Sphyrna-029/Pico-Pilot/README.md

# Pico-Pilot WIP
A auto pilot for land/air/sea based robots built on the RP2350B/RP2354B. Supports 2D waypoint missions, telemetry, and custom vehicle configuration. 
Requires simple_pid and warnings packages. 

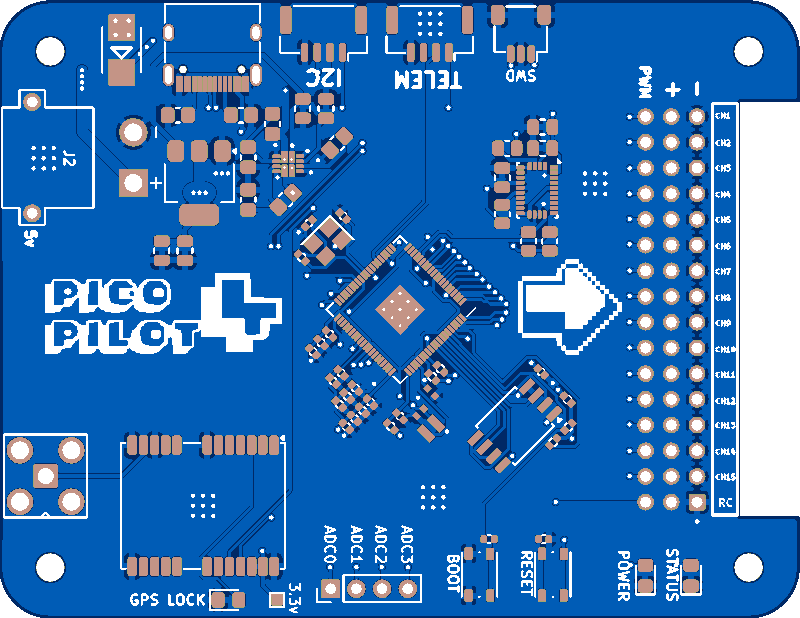
[picture p1: images/Pico4.png]
PicoPilot v4
