Sphyrna-029/Pico-Pilot/images/Pico3.PNG

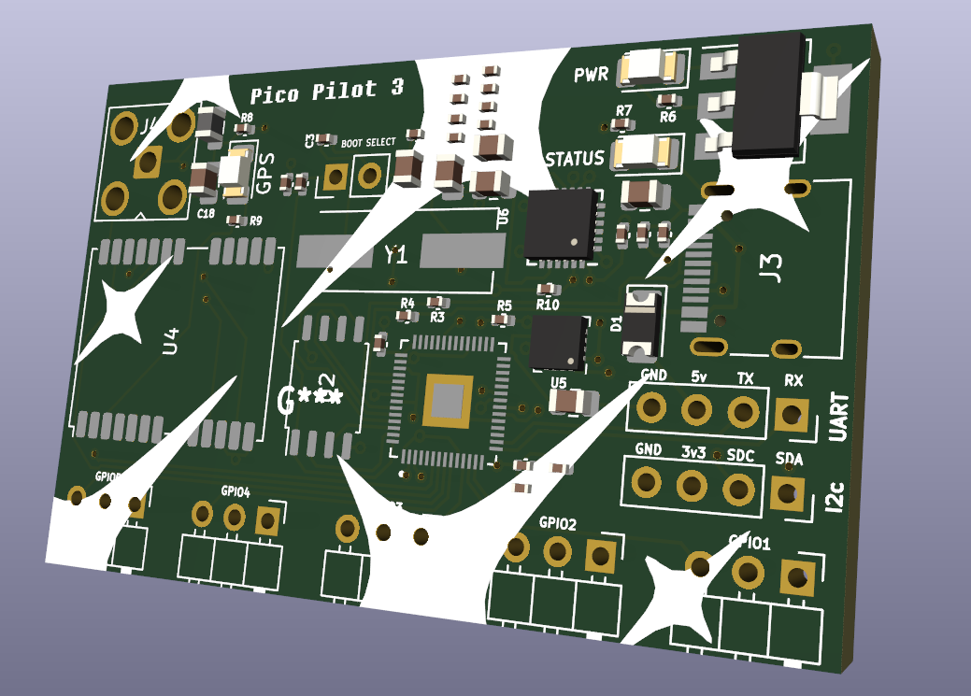
images/Pico3.PNG
