Sphyrna-029/Pico-Pilot/images/pico_2.jpg

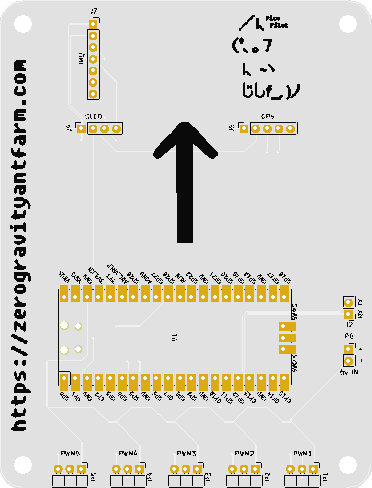
images/pico_2.jpg
