Sphyrna-029/Pico-Pilot/images/PicoPilot.png

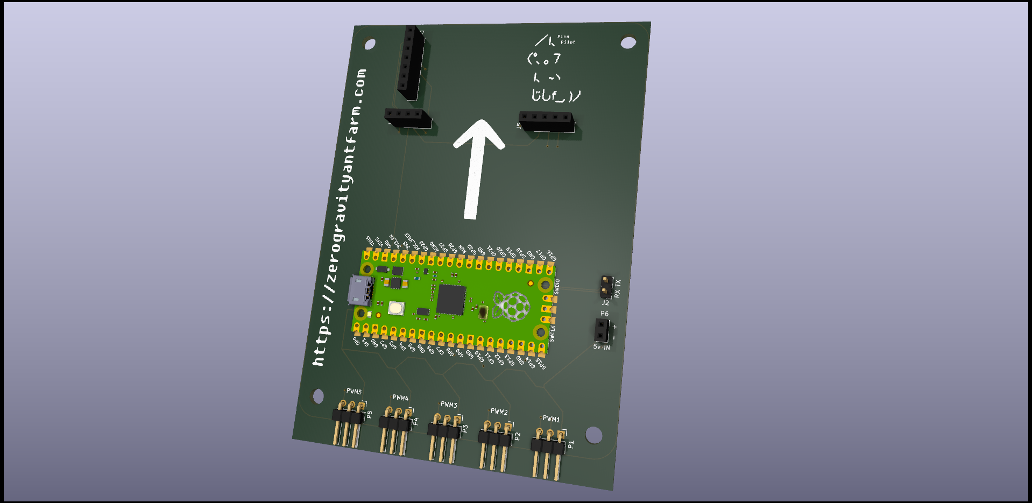
images/PicoPilot.png
