Sphyrna-029/Pico-Pilot/images/PicoPilotv02.PNG

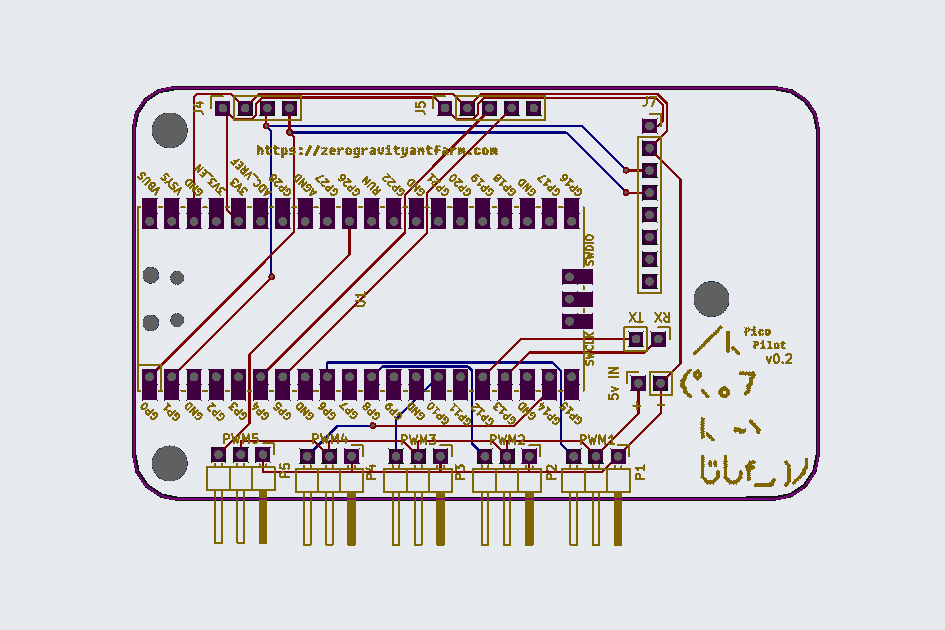
images/PicoPilotv02.PNG
