Sphyrna-029/Pico-Pilot/images/PicoPilotv03.PNG

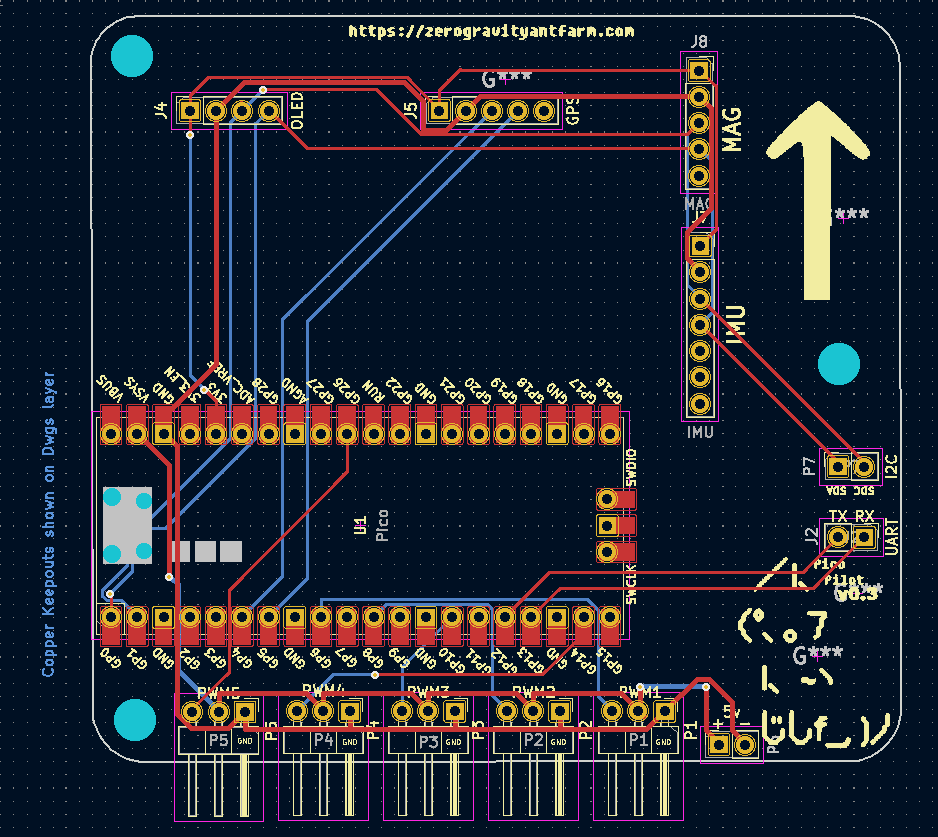
images/PicoPilotv03.PNG
