Sphyrna-029/Pico-Pilot/pcb/RP2350_QFN80.step

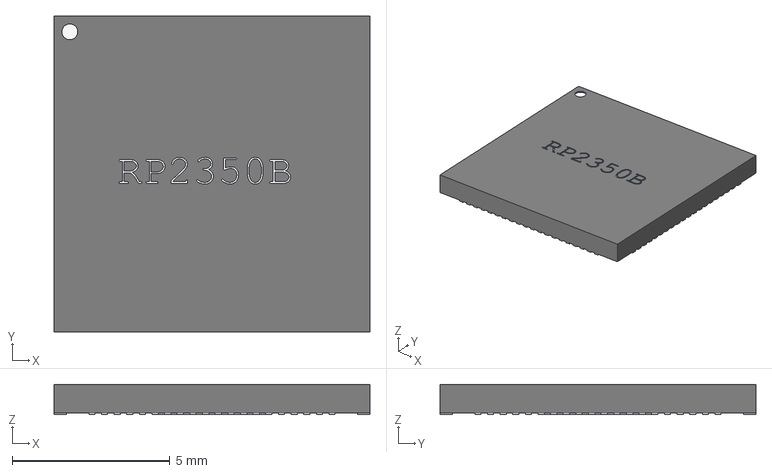
[picture p7: CAD file, 2024-08-15]
pcb/RP2350_QFN80.step
10.0 x 10.0 x 0.95 mm
