Sphyrna-029/Pico-Pilot/pcb/RP2350_80QFN_minimal.kicad_pcb

## KiCad design pcb/RP2350_80QFN_minimal.kicad_pcb (2024-08-17)

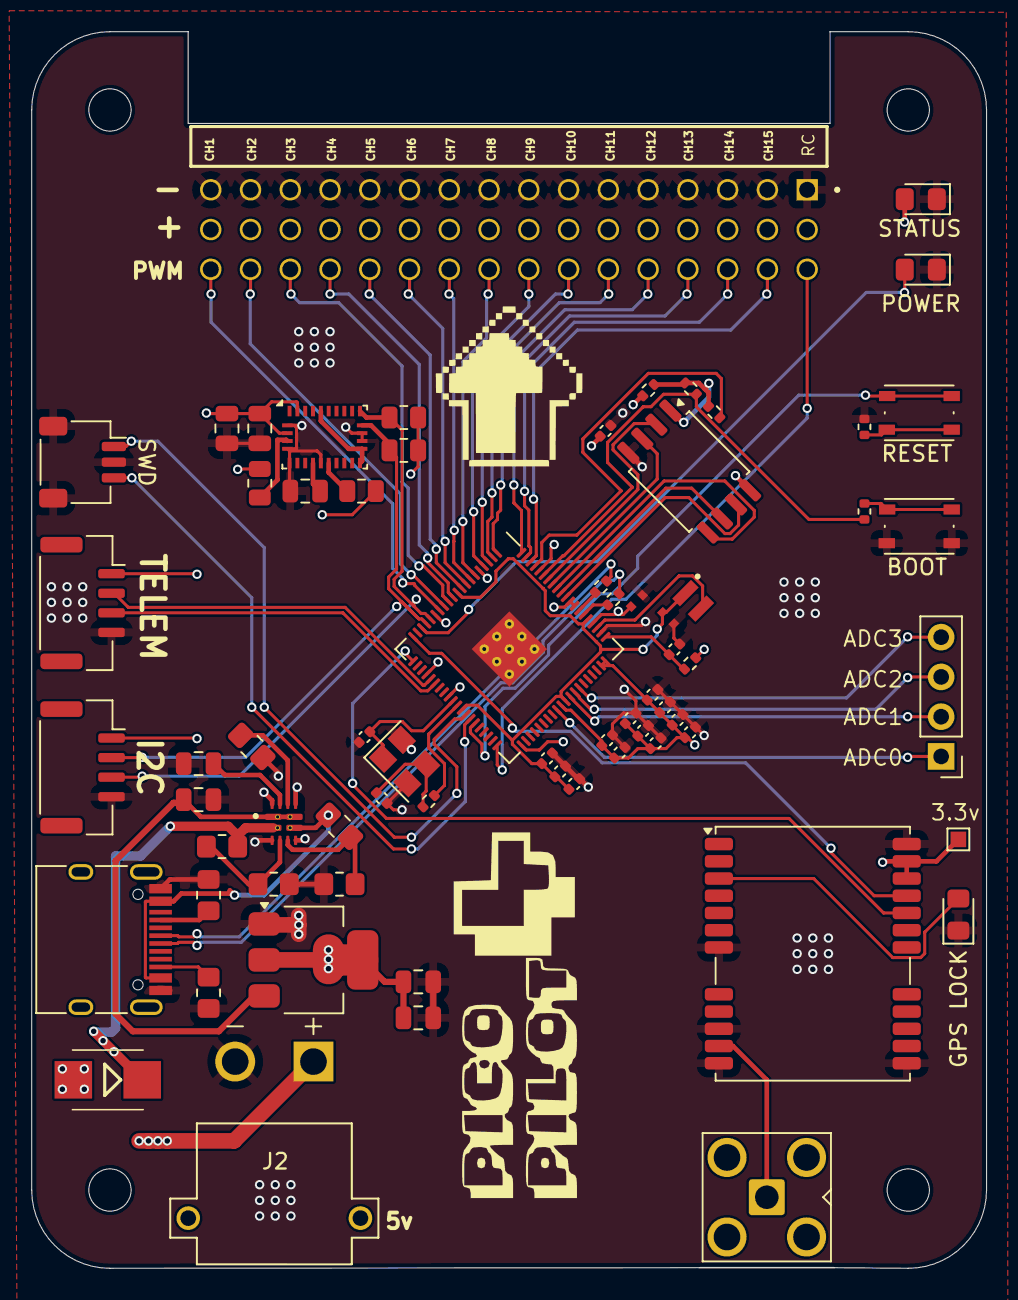
[picture p8: board RP2350_80QFN_minimal.kicad_pcb from above]

Board: 4 copper layers, 61.0 x 79.0 mm, 72 parts (0 on the bottom side), 68 nets.

Parts:
BOOT: SW_Push; SW_Push_1P1T_NO_Vertical_Wuerth_434133025816
C1, C5, C19: 10u; C_0805_2012Metric
C2, C8, C11, C12, C13, C14, C15, C16, C17, C18, C20, C21: 100n; C_0402_1005Metric
C3, C4: 15p; C_0402_1005Metric
C6, C7: 4.7u; C_0402_1005Metric_small_pads
C9, C10: 4.7u; C_0402_1005Metric
C22: 100nF; C_0805_2012Metric
C23: 120nF; C_0805_2012Metric
C24: 6.8nF; C_0805_2012Metric
C25: 0.01u; C_0805_2012Metric
D1, D2, D3: LED; LED_0805_2012Metric_Pad1.15x1.40mm_HandSolder
D4: SS56; SMB
H1, H2, H3, H4: MountingHole; MountingHole_2.7mm_M2.5
J1: USB_C_Receptacle_USB2.0_14P; USB_C_Receptacle_HRO_TYPE-C-31-M-12
J2: XT30PW-M; AMASS_XT30PW-M
J3, J6: Conn_01x04_Pin; Molex_CLIK-Mate_502386-0470_1x04-1MP_P1.25mm_Horizontal
J4: SM03B-SRSS-TB; JST_SH_SM03B-SRSS-TB_1x03-1MP_P1.00mm_Horizontal
J5: TSW-116-08-G-T-RA; SAMTEC_TSW-116-08-G-T-RA
J7: Conn_01x04_Pin; PinHeader_1x04_P2.54mm_Vertical
J8: Conn_Coaxial_Small; SMA_Amphenol_901-143_Horizontal
L1: 3.3u; L_pol_2016
R1, R9: DNF; R_0402_1005Metric
R2, R4, R6: 1k; R_0402_1005Metric
R3: 33; R_0402_1005Metric
R5, R12: 5.1k; R_0805_2012Metric_Pad1.20x1.40mm_HandSolder
R7, R8: 27; R_0402_1005Metric
R10: 0; R_0402_1005Metric
R11, R15: 10k; R_0805_2012Metric
R13, R14: 4.7k; R_0805_2012Metric
R16: 51.1k; R_0805_2012Metric_Pad1.20x1.40mm_HandSolder
R17, R19: 23.7k; R_0805_2012Metric_Pad1.20x1.40mm_HandSolder
R18, R20: 5k; R_0805_2012Metric_Pad1.20x1.40mm_HandSolder
RESET: SW_Push; SW_Push_1P1T_NO_Vertical_Wuerth_434133025816
TP1: TestPoint; TestPoint_Pad_1.0x1.0mm
U1: RP2350_80QFN; RP2350-QFN-80-1EP_10x10_P0.4mm_EP3.4x3.4mm_ThermalVias
U2: NCP1117-3.3_SOT223; SOT-223-3_TabPin2
U3: W25Q128JVS; SOIC-8_5.23x5.23mm_P1.27mm
U4: NEO-M9N; ublox_NEO
U5: BNO055; LGA-28_5.2x3.8mm_P0.5mm
U6: TPS2121RUXR; IC_TPS2121RUXR
Y1: ABM8-272-T3; Crystal_SMD_3225-4Pin_3.2x2.5mm

Connections:
+1V1: C7.1, C8.1, C10.1, C11.1, L1.1, U1.10 (DVDD), U1.32 (DVDD), U1.51 (DVDD), U1.65 (VREG_FB)
+3V3: C2.1, C5.1, C6.1, C12.1, C13.1, C14.1, C15.1, C16.1, C17.1, C18.1, C19.1, C20.1, C21.1, C23.2, C24.2, D2.2 (A), J3.1, J6.1, R1.1, R3.1, R11.1, R13.2, R14.2, R15.1, TP1.1, U1.5 (IOVDD), U1.15 (IOVDD), U1.24 (IOVDD), U1.29 (IOVDD), U1.41 (IOVDD), U1.50 (IOVDD), U1.59 (ADC_AVDD), U1.60 (IOVDD), U1.64 (VREG_VIN), U1.68 (USB_OTP_VDD), U1.69 (QSPI_IOVDD), U1.76 (IOVDD), U2.2 (VO), U3.8 (VCC), U4.22 (V_BCKP), U4.23 (VCC), U5.3 (VDD), U5.28 (VDDIO)
/FLASH_SS: R1.2, R9.2, R10.2, U3.1 (~CS)
/GPIO0: R9.1, U1.77 (GPIO0)
/GPIO1: J5.06, U1.78 (GPIO1)
/GPIO2: J5.09, U1.79 (GPIO2)
/GPIO3: J5.12, U1.80 (GPIO3)
/GPIO4: J5.15, U1.1 (GPIO4)
/GPIO5: J5.18, U1.2 (GPIO5)
/GPIO6: J5.21, U1.3 (GPIO6)
/GPIO7: J5.24, U1.4 (GPIO7)
/GPIO8: J5.27, U1.6 (GPIO8)
/GPIO9: J5.30, U1.7 (GPIO9)
/GPIO10: J5.33, U1.8 (GPIO10)
/GPIO11: J5.36, U1.9 (GPIO11)
/GPIO12: J5.39, U1.11 (GPIO12)
/GPIO13: J5.42, U1.12 (GPIO13)
/GPIO14: J5.45, U1.13 (GPIO14)
/GPIO15: J5.48, U1.14 (GPIO15)
/GPIO18: D1.2 (A), U1.18 (GPIO18)
/GPIO20: U1.20 (GPIO20), U4.21 (RXD/SPI_MOSI)
/GPIO21: U1.21 (GPIO21), U4.20 (TXD/SPI_MISO)
/GPIO24: J3.2, U1.25 (GPIO24)
/GPIO25: J3.3, U1.26 (GPIO25)
/GPIO32: J5.03, U1.40 (GPIO32)
/GPIO40_ADC0: J7.1, U1.49 (GPIO40_ADC0)
/GPIO41_ADC1: J7.2, U1.52 (GPIO41_ADC1)
/GPIO42_ADC2: J7.3, U1.53 (GPIO42_ADC2)
/GPIO43_ADC3: J7.4, U1.54 (GPIO43_ADC3)
/QSPI_SCLK: U1.71 (QSPI_SCLK), U3.6 (CLK)
/QSPI_SD0: U1.72 (QSPI_SD0), U3.5 (DI(IO0))
/QSPI_SD1: U1.74 (QSPI_SD1), U3.2 (DO(IO1))
/QSPI_SD2: U1.73 (QSPI_SD2), U3.3 (IO2)
/QSPI_SD3: U1.70 (QSPI_SD3), U3.7 (IO3)
/QSPI_SS: R6.1, R10.1, U1.75 (QSPI_SS)
/RUN: RESET.2, U1.35 (RUN)
/SWCLK: J4.1, U1.33 (SWCLK)
/SWD: J4.3, U1.34 (SWD)
/USB_D+: J1.A6 (D+), R7.1
/USB_D-: J1.A7 (D-), R8.1
/VREG_AVDD: C9.1, R3.2, U1.61 (VREG_AVDD)
/VREG_LX: L1.2, U1.63 (VREG_LX)
/XIN: C3.1, U1.30 (XIN), Y1.1
/XOUT: R2.1, U1.31 (XOUT)
/~USB_BOOT: BOOT.2, R6.2
GND: BOOT.1, C1.2, C2.2, C3.2, C4.2, C5.2, C6.2, C7.2, C8.2, C9.2, C10.2, C11.2, C12.2, C13.2, C14.2, C15.2, C16.2, C17.2, C18.2, C19.2, C20.2, C21.2, C22.2, C23.1, C24.1, C25.2, D1.1 (K), D2.1 (K), D3.1 (K), J1.A1 (GND), J1.A12 (GND), J1.B1 (GND), J1.B12 (GND), J2.N, J3.4, J4.2, J4.MP (MountPin), J5.01, J5.04, J5.07, J5.10, J5.13, J5.16, J5.19, J5.22, J5.25, J5.28, J5.31, J5.34, J5.37, J5.40, J5.43, J5.46, J6.4, R4.2, R5.1, R12.1, R16.1, R18.1, R20.1, U1.62 (VREG_PGND), U1.81 (GND), U2.1 (GND), U3.4 (GND), U4.7 (VDD_USB), U4.10 (GND), U4.12 (GND), U4.13 (GND), U4.24 (GND), U5.2 (GND), U5.5 (PS1), U5.6 (PS0), U5.10 (BL_IND), U5.17 (COM3), U5.18 (COM2), U6.3 (CP2), U6.6 (PR1), U6.9 (ST), U6.12 (GND), Y1.2, Y1.4
unnamed: C4.1, R2.2, Y1.3
unnamed: D3.2 (A), U4.3 (TIMEPULSE)
unnamed: D4.C, R17.2, U6.2 (IN2), U6.2_1 (IN2)
unnamed: J1.A5 (CC1), R5.2
unnamed: J1.B5 (CC2), R12.2
unnamed: J8.1 (In), U4.11 (RF_IN)
unnamed: R4.1, RESET.1
unnamed: R8.2, U1.66 (USB_DM)
unnamed: R7.2, U1.67 (USB_DP)
unnamed: C22.1, U5.9 (CAP)
unnamed: U5.15 (GNDIO), U5.16 (GNDIO), U5.25 (GNDIO)
unnamed: R11.2, U5.4 (~BOOT_LOAD_PIN)
unnamed: R15.2, U5.11 (~RESET)
unnamed: R16.2, U6.10 (ILIM)
unnamed: R19.1, R20.2, U6.5 (OV1)
unnamed: R17.1, R18.2, U6.4 (OV2)
unnamed: C25.1, U6.11 (SS)
SDA: J6.3, R13.1, U1.16 (GPIO16), U5.20 (COM0)
SDL: J6.2, R14.1, U1.17 (GPIO17), U5.19 (COM1)
USBV: J1.A4 (VBUS), J1.A9 (VBUS), J1.B4 (VBUS), J1.B9 (VBUS), R19.2, U6.7 (IN1), U6.7_1 (IN1)
VBUS: D4.A, J2.P, J5.02, J5.05, J5.08, J5.11, J5.14, J5.17, J5.20, J5.23, J5.26, J5.29, J5.32, J5.35, J5.38, J5.41, J5.44, J5.47
VOUT: C1.1, U2.3 (VI), U6.1 (OUT), U6.1_1 (OUT), U6.8 (OUT), U6.8_1 (OUT)
