Sphyrna-029/Pico-Pilot/firmware/auto.py

from machine import Pin, UART, I2C
from ssd1306 import SSD1306_I2C
from imu import MPU6050
import utime, time
import _thread
import json

#Instantiate our static objects
i2c = I2C(0, sda=Pin(0), scl=Pin(1), freq=400000)
oled = SSD1306_I2C(128, 64, i2c)
gpsModule = UART(1, baudrate=9600, tx=Pin(4), rx=Pin(5))
telemetry = UART(0, baudrate=9600, tx=Pin(12), rx=Pin(13))
imu = MPU6050(i2c)

#Open our vehicle config
with open("vehicle.config") as configfile:
    vehicleConfig = json.load(configfile)
    configfile.close()
    print("Config loaded!")

#Perform self health check
def post():
    oled.fill(0)
    oled.text("POST", 0, 0)
    oled.show()
    time.sleep(2)
   
    devices = i2c.scan()
    
    if len(devices) == 0:
        oled.fill(0)
        oled.text("POST -", 0, 0)
        oled.text("I2c bus error.", 0, 30) 
        oled.show()
        return False
    
    else:
        oled.fill(0)
        oled.text("POST +", 0, 0)
        oled.text("I2c check pass!", 0, 30)
        oled.text(str(devices), 0, 40)
        oled.show()
        time.sleep(5)
        return True

#Determine if POST is required
if vehicleConfig["PowerOnSelfTest"]:
    selfcheck = post()

    if not selfcheck:
        oled.fill(0)
        oled.text("POST -", 0, 0)
        oled.text("POST failed.", 0, 30)
        oled.text("Please check", 0, 40)
        oled.text("device.", 0, 50)
        oled.show()
        time.sleep(2)
    

#GPS Vars
buff = bytearray(255)
FIX_STATUS = False
latitude = ""
longitude = ""
satellites = ""
GPStime = ""


#GPS Handler Function
def getGPS():
    global FIX_STATUS, latitude, longitude, satellites, GPStime
    
    while True:
        gpsModule.readline()
        buff = str(gpsModule.readline())
        parts = buff.split(',')
    
        if (parts[0] == "b'$GPGGA" and len(parts) == 15):
            if(parts[1] and parts[2] and parts[3] and parts[4] and parts[5] and parts[6] and parts[7]):
                print(buff)
                
                latitude = convertToDegree(parts[2])
                if (parts[3] == 'S'):
                    latitude = '-' + latitude
                longitude = convertToDegree(parts[4])
                if (parts[5] == 'W'):
                    longitude = '-' + longitude
                satellites = parts[7]
                GPStime = parts[1][0:2] + ":" + parts[1][2:4] + ":" + parts[1][4:6]
                FIX_STATUS = True
                
        else:
            FIX_STATUS = False
            
        utime.sleep_ms(500)

#Gather IMU Data 
def getImu():
    data = []
    
    ax=round(imu.accel.x,2)
    ay=round(imu.accel.y,2)
    az=round(imu.accel.z,2)
    gx=round(imu.gyro.x)
    gy=round(imu.gyro.y)
    gz=round(imu.gyro.z)
    tem=round(imu.temperature,2)
    
    data.append(ax)
    data.append(ay)
    data.append(az)
    data.append(gx)
    data.append(gy)
    data.append(gz)
    data.append(tem)

    return data


def convertToDegree(RawDegrees):
    RawAsFloat = float(RawDegrees)
    firstdigits = int(RawAsFloat/100) 
    nexttwodigits = RawAsFloat - float(firstdigits*100) 
    
    Converted = float(firstdigits + nexttwodigits/60.0)
    Converted = '{0:.6f}'.format(Converted) 
    return str(Converted)
    
#Instaniate GPS Thread
_thread.start_new_thread(getGPS, ())

#Main thread
while True:
    
    print("Latitude: "+latitude)
    print("Longitude: "+longitude)
    print("Satellites: " +satellites)
    print("Time: "+GPStime)
    print("----------------------")
    print(getImu())
        
    oled.fill(0)
    oled.text("----------------------", 0, 0)
    oled.text("La: "+latitude, 0, 20)
    oled.text("Lo: "+longitude, 0, 30)
    oled.text("Sat: "+satellites, 0, 40)
    oled.text("T: "+GPStime, 0, 50)
    oled.show()
        
    time.sleep(vehicleConfig["UpdateFrequencyHz"])
