Sphyrna-029/Pico-Pilot/(commit log)

2024-02-11 Circle Shortest Path
    Rudder control loop checks for shortest path on circle from current heading to target heading.
    [PicoPilot.py, main.py]
2024-08-17 RP Diode
    [RP2350_80QFN_minimal.kicad_pcb]
